luoluoluo312/STM32-ultrasonic-distance-alarm/README.md

# STM32 超声波测距报警器

基于 **STM32F103C8T6** + **标准外设库（SPL）** 的入门级小项目（Keil MDK5 工程）：
用 **HC-SR04 超声波模块**测距，把报警阈值和实时距离显示在 **0.96 寸 I2C OLED** 上，
距离小于 **10cm** 时**蜂鸣器报警**。

---

## 1. 功能

| 功能 | 说明 |
| --- | --- |
| 定时器测距 | TIM4_CH2 输入捕获测回波高电平脉宽，`距离(cm) = 脉宽(us) ÷ 58`，精度 0.1cm |
| OLED 显示 | 第 1 行固定显示报警阈值 `Threshold 10cm`，中间显示实时距离 |
| 声光报警 | 距离 < 10cm 时 PA0 输出 2.7kHz 方波驱动蜂鸣器；平时静音 |
| 超量程处理 | 没插传感器 / 超出量程时显示 `--.- cm`，**不会误报警** |
| 硬件 I2C | OLED 走 I2C1（重映射到 PB8/PB9），400kHz，从机地址 0x78 |

界面长这样（4 行，8 像素高的英文点阵字体）：

```
Threshold 10cm          <- 第 1 行：固定显示报警阈值
Distance                <- 第 2 行：标题
      12.3 cm           <- 第 3 行：实时距离（屏幕中间）
OK                      <- 第 4 行：报警状态，<10cm 时变成 ALARM  <10cm
```

---

## 2. 硬件清单

| 元器件 | 数量 | 本项目中的作用 |
| --- | --- | --- |
| STM32F103C8T6 最小系统板（蓝板） | 1 | 主控，72MHz |
| ST-Link V2 下载器 | 1 | 下载程序、调试（SWD），也可以给板子供电 |
| HC-SR04 超声波模块 | 1 | 测距 |
| 0.96 寸 I2C OLED（128×64） | 1 | 显示阈值和距离 |
| 无源蜂鸣器模块（低电平触发） | 1 | 报警 |
| 面包板 + 杜邦线 | 1 套 | 搭电路 |

---

## 3. 接线表

蓝板丝印是简写：`PB6` 印成 **B6**、`PB7` 印成 **B7**、`PA0` 印成 **A0**、`PB8/PB9` 印成 **B8/B9**。

| 模块 | 模块引脚 | 接到蓝板 | 说明 |
| --- | --- | --- | --- |
| HC-SR04 | VCC | **5V** | 建议 5V；蓝板 5V 脚只有在 USB 供电（或 ST-Link 5V 接上）时才有电 |
| HC-SR04 | Trig | **PB6** | 推挽输出 |
| HC-SR04 | Echo | **PB7** | 输入（TIM4_CH2 输入捕获）；Echo 输出 5V 电平，PB7 是 5V 容忍脚，安全 |
| HC-SR04 | GND | **GND** | |
| OLED | GND / VCC / SCL / SDA | GND / **3V3** / **PB8** / **PB9** | 从机地址 0x78，VCC 不要接 5V |
| 蜂鸣器 | VCC | **3V3** | 低电平触发的模块**必须 3.3V**，接 5V 会关不断 |
| 蜂鸣器 | I/O | **PA0** | 定时器 PWM 输出（TIM2_CH1） |
| 蜂鸣器 | GND | **GND** | |
| ST-Link | SWDIO / SWCLK / GND / 3.3V | 板子末端 4 针 SWD 排针 | |

**三条铁律**

1. 所有模块的 GND 必须和蓝板共地，否则读数乱跳。
2. 除超声波模块外，模块供电都用 3V3；接 5V 容易打坏引脚。
3. 蓝板 3V3 引脚的带载能力有限（约 100~150mA），本项目够用，但别用它驱动电机。

**两种供电方案（二选一，别混用）**

- **推荐**：蓝板插 micro-USB 供电，ST-Link 只接 SWDIO / SWCLK / GND 三根。
  这样蓝板 5V 脚有 5V，超声波可以用 5V。
- 只用 ST-Link 供电：ST-Link 的 3V3 接蓝板 3V3，超声波 VCC 也接 3V3
  （多数模块也能测，量程略短）。

**建议的接线顺序（一步一步来，别一次全插上）**

1. 先只接 **ST-Link + OLED**，上电：屏幕应显示 `Threshold 10cm` / `Distance` / `--.- cm` / `OK`。
2. 断电，接 **超声波 4 根线**，上电：`--.- cm` 变成数字，手在探头前晃动，数字跟着变。
3. 断电，接 **蜂鸣器**（VCC→3V3、I/O→PA0、GND→GND），上电。
4. 拿张纸靠近到 10cm 以内：第 4 行变成 `ALARM  <10cm`，蜂鸣器响；拿开就停。

> 每次改完接线都要**重新上电或按复位键**，因为 OLED 只在开机时初始化一次。

---

## 4. 目录结构

```
stm32模板/
├── user/                        # 用户代码（本项目主要改这里）
│   ├── main.c                   # ★ 本项目全部功能：测距 + 显示 + 报警
│   ├── stm32f10x_it.c           # 中断服务函数（SysTick 计时 + TIM4 回波捕获）
│   ├── stm32f10x_it.h
│   ├── stm32f10x_conf.h
│   └── system_stm32f10x.c/.h     # 系统时钟（72MHz）
├── my_lib/                      # 套件配套驱动库
│   ├── i2c.c/.h                 # ★ 硬件 I2C（OLED 用，带超时保护）
│   ├── oled.c/.h                # OLED 图形库：点、线、圆、矩形、位图、字符串
│   ├── oled_font.h / oled_default_font.h   # 8 像素高的英文字库
│   ├── delay.c/.h               # SysTick 毫秒 / 微秒计时
│   └── si2c.c/.h, button.c/.h, usart.c/.h, spi.c/.h   # 本项目未使用，保留
├── std_periph_driver/           # ST 官方标准外设库（SPL V3.6.0）
├── startup/                     # 启动文件（本工程用 startup_stm32f10x_md.s）
├── my_app/                      # 上一版"光照监测"项目的资料（本项目未使用，保留备查）
└── stm32模板.uvprojx             # Keil MDK5 工程文件
```

---

## 5. 编译与烧录

1. 用 **Keil µVision 5（MDK5，ARMCC V5 编译器）** 打开 `stm32模板.uvprojx`；
2. `F7` 编译（0 错误 0 警告）；
3. 接好 ST-Link，`F8` 下载；也可以直接用别的工具烧 `Objects/template.hex`。

工程已经包含全部源文件和包含路径，不需要额外配置
（芯片：STM32F103C8，ROM 64K / RAM 20K，使用 microLIB）。

> Keil 里如果看到中文注释乱码：`Edit → Configuration → Encoding` 选 **UTF-8**，
> 不影响编译结果。

---

## 6. 实现要点

### 6.1 用输入捕获测回波脉宽

TIM4 挂在 APB1 上，定时器时钟 72MHz。分频 72 之后计数频率是 **1MHz**，
也就是**一个计数正好 1 微秒**，量程 ARR = 0xFFFF（一次最多量 65.5ms；
HC-SR04 没有回波时回波高电平约 38ms，够用）。

一次测距的时序：

1. 主循环每 100ms 把 **TRIG(PB6)** 拉高约 10us 再拉低；
2. HC-SR04 发出 8 个 40kHz 脉冲，然后 **ECHO(PB7)** 变高；
3. ECHO 的**上升沿**被 TIM4_CH2 捕获，中断里记下捕获值，同时把捕获极性改成**下降沿**；
4. ECHO 的**下降沿**被捕获，中断里算
   `脉宽 = 下降沿捕获值 − 上升沿捕获值`（16 位无符号相减，自动处理计数溢出）；
5. 主循环取走脉宽算距离：`距离(0.1cm) = 脉宽(us) × 10 ÷ 58`；
6. 如果 60ms 都没等到回波，就把捕获重新武装成上升沿，距离判为无效（屏幕显示 `--.-`）。

无效范围：脉宽 < 100us（约 1.7cm）或 > 24000us（约 413cm）都当作无效，避免乱报警。

### 6.2 报警输出

PA0 复用成 **TIM2_CH1** 输出 PWM：

- 距离 < 10cm：比较值取一半，输出 **2.7kHz、50% 占空比的方波**（无源蜂鸣器这才有声）；
- 平时：比较值给 0，用 **PWM 模式2** 让引脚输出**恒高电平**，模块关断、安静。

### 6.3 OLED 用硬件 I2C1

STM32F103 的 **I2C1 默认引脚是 PB6/PB7**，而 PB6/PB7 正好被超声波占了，
所以必须打开 **I2C1 重映射**（`GPIO_PinRemapConfig(GPIO_Remap_I2C1, ENABLE)`），
把 SCL/SDA 挪到 **PB8/PB9**。这也是代码里要开 AFIO 时钟的原因。

另外 `my_lib/i2c.c` 里所有等待标志位的死循环都加了**超时**：
屏幕没接、总线没有上拉电阻时，F1 的 I2C 会把 BUSY 锁死，
原来的写法会让程序卡死在启动阶段。加了超时以后，
屏幕有问题只是不显示，测距和报警照常工作。

---

## 7. 踩过的两个坑（留着给以后的自己看）

### 7.1 冷启动黑屏，按一下复位就好了

SSD1306 上电后要等 **100ms 以上**才会应答 I2C。程序原来一上电（约 5ms）就去找它，
必然寻址失败；三次重试全失败后就再也不重试了，于是一直黑屏。

解决：初始化屏幕前先 `Delay(250)` 再重试。
后来用调试器直接驱动 I2C 总线验证过：模块确实在 0x78 地址应答，
接线和地址都没问题，纯粹是**上电时序**问题。

### 7.2 蜂鸣器不响

套件里这个模块是「**低电平触发 + 无源**」的：

- 无源蜂鸣器必须给**方波**才发声，给固定的高/低电平只会"咔"一声；
- 低电平触发意味着"给低电平才通电"，和"高电平响"正好相反。

解决：报警时输出 2.7kHz 方波，平时输出恒高电平。

---

## 8. 常见问题

| 现象 | 原因与处理 |
| --- | --- |
| 屏幕全黑 | ① 冷启动时序（已修）；② 检查 OLED 的 SCL→PB8、SDA→PB9、VCC→3V3、GND→GND；③ 改完接线要复位 |
| 一直显示 `--.- cm` | 超声波没接好：VCC/GND 是否接上、Trig 是否接 PB6、Echo 是否接 PB7 |
| 距离数值乱跳 | ① 所有模块共地了吗；② 探头表面有没有贴膜；③ 测量面太软、太斜也会跳 |
| 蜂鸣器一直响 | 蜂鸣器模块 VCC 误接 5V（低电平触发的模块必须 3.3V） |
| 蜂鸣器不响 | ① I/O 是否接到 PA0；② 模块 VCC 是否 3.3V；③ 距离要**小于** 10cm 才报警（正好 10.0cm 不报） |
| 想改引脚 | 全部集中在 `user/main.c` 顶部"一、硬件配置区" |

---

## 9. 和需求原文的一处偏差

需求原文写的是「距离 < 10cm 时 PA0 输出**高电平**驱动蜂鸣器，否则输出低电平」。
实测发现套件里这块蜂鸣器模块是**低电平触发**且**无源**的：
给它静态高电平既不响（无源需要方波），逻辑方向也是反的。所以本项目按确认后的方案改成：

- 报警时 PA0 输出 **2.7kHz 方波**；
- 平时 PA0 输出**恒高电平**（让低电平触发模块关断）。

如果以后换成「**高电平触发**」的蜂鸣器模块，想严格按需求原文做，
只需改 `Buzzer_Init()` 里两处：PWM 模式改成 `TIM_OCMode_PWM1`、
静音时的比较值改成 `ARR + 1`。代码注释里都写了。

---

## 10. 说明与致谢

- `my_lib/` 驱动库和硬件套件来自 B 站 **铁头山羊** 的
  《STM32 入门教程（第 4 版）基础套件》，本项目仅作个人学习使用。
- `std_periph_driver/` 为 ST 官方标准外设库 V3.6.0。
- `my_app/` 里的中文字库、预览脚本等是上一版"光照监测"项目留下的，本项目没用到，保留备查；
  那一版的说明文档**原样保存**在 `my_app/README-光照监测-旧项目.md`
  （它的代码在另一个仓库 [stm32project](https://github.com/luoluoluo312/stm32project) 里）。
- 为避免仓库过大，套件自带的字体文件（`my_lib/font/ttfttc/*.ttf`）和实物照片没有放进仓库。
