luoluoluo312/STM32-ultrasonic-distance-alarm/my_lib/i2c.c

/**
  ******************************************************************************
  * @file    i2c.c
  * @author  铁头山羊
  * @version V 1.0.0
  * @date    2024年9月3日
  * @brief   i2c驱动源文件
  ******************************************************************************
  */
#include "i2c.h"

//
// @简介：带超时的标志位等待
//  I2C 总线异常时（例如没接从机、总线上没有上拉电阻），BUSY/SB 等标志可能
//  一直不翻转，这里加超时，避免程序死等。
// @返回值：0 - 等到， -1 - 超时
//
#define MY_I2C_TIMEOUT   100000UL

static int My_I2C_WaitFlag(I2C_TypeDef *I2Cx, uint32_t Flag, FlagStatus Status)
{
	uint32_t Timeout = MY_I2C_TIMEOUT;
	
	while(I2C_GetFlagStatus(I2Cx, Flag) != Status)
	{
		if(--Timeout == 0)
		{
			return -1;
		}
	}
	
	return 0;
}

//
// @简介：通过I2C向从机写入多个字节
// 
// @参数 I2Cx：填写要操作的I2C的名称，可以是I2C1或I2C2
// @参数 Addr：填写从机的地址，左对齐 - A6 A5 A4 A3 A2 A1 A0 0
// @参数 pData：要发送的数据（数组）
// @参数 Size：要发送的数据的数量，以字节为单位
//
// @返回值：0 - 发送成功， -1 - 寻址失败， -2 - 数据被拒收， -3 - 超时(总线异常)
//
__weak int My_I2C_SendBytes(I2C_TypeDef *I2Cx, uint8_t Addr, const uint8_t *pData, uint16_t Size)
{
	// #1. 等待总线空闲
	if(My_I2C_WaitFlag(I2Cx, I2C_FLAG_BUSY, RESET) != 0)
	{
		return -3; // 总线一直忙（例如从机没接、总线没有上拉）
	}
	
	// #2. 发送起始位
	I2C_GenerateSTART(I2Cx, ENABLE);
	
	if(My_I2C_WaitFlag(I2Cx, I2C_FLAG_SB, SET) != 0)
	{
		I2C_GenerateSTOP(I2Cx, ENABLE);
		return -3; // 起始位没能发出去
	}
	
	// #3. 寻址阶段
	I2C_ClearFlag(I2Cx, I2C_FLAG_AF);
	
	I2C_SendData(I2Cx, Addr & 0xfe);
	
	uint32_t Timeout = MY_I2C_TIMEOUT;
	
	while(1)
	{
		if(I2C_GetFlagStatus(I2Cx, I2C_FLAG_ADDR) == SET)
		{
			break;
		}
		if(I2C_GetFlagStatus(I2Cx, I2C_FLAG_AF) == SET)
		{
			I2C_GenerateSTOP(I2Cx, ENABLE);
			return -1; // 寻址失败
		}
		if(--Timeout == 0)
		{
			I2C_GenerateSTOP(I2Cx, ENABLE);
			return -3; // 超时
		}
	}
	
	// 清除ADDR
	I2C_ReadRegister(I2Cx, I2C_Register_SR1);
	I2C_ReadRegister(I2Cx, I2C_Register_SR2);
	
	// #4. 发送数据
	for(uint16_t i=0; i<Size; i++)
	{
		Timeout = MY_I2C_TIMEOUT;
		
		while(1)
		{
			if(I2C_GetFlagStatus(I2Cx, I2C_FLAG_AF) == SET)
			{
				I2C_GenerateSTOP(I2Cx, ENABLE);
				return -2; // 数据被拒收
			}
			if(I2C_GetFlagStatus(I2Cx, I2C_FLAG_TXE) == SET)
			{
				break;
			}
			if(--Timeout == 0)
			{
				I2C_GenerateSTOP(I2Cx, ENABLE);
				return -3; // 超时
			}
		}
		
		I2C_SendData(I2Cx, pData[i]);
	}
	
	Timeout = MY_I2C_TIMEOUT;
	
	while(1)
	{
		if(I2C_GetFlagStatus(I2Cx, I2C_FLAG_AF) == SET)
		{
				I2C_GenerateSTOP(I2Cx, ENABLE);
				return -2; // 数据被拒收			
		}
		
		if(I2C_GetFlagStatus(I2Cx, I2C_FLAG_BTF) == SET)
		{
			break;
		}
		
		if(--Timeout == 0)
		{
				I2C_GenerateSTOP(I2Cx, ENABLE);
				return -3; // 超时
		}
	}
	
	// #5. 发送停止位
	I2C_GenerateSTOP(I2Cx, ENABLE);
	return 0; // 成功
}


//
// @简介：通过I2C从从机读多个字节
// 
// @参数 I2Cx：填写要操作的I2C的名称，可以是I2C1或I2C2
// @参数 Addr：填写从机的地址，左对齐 - A6 A5 A4 A3 A2 A1 A0 0
// @参数 pBuffer：接收缓冲区（数组）
// @参数 Size：要读取的数据的数量，以字节为单位
//
// @返回值：0 - 发送成功， -1 - 寻址失败
//
__weak int My_I2C_ReceiveBytes(I2C_TypeDef *I2Cx, uint8_t Addr, uint8_t *pBuffer, uint16_t Size)
{
	if(Size == 0) return 0;
	
	// #1. 等待总线空闲
	while(I2C_GetFlagStatus(I2Cx, I2C_FLAG_BUSY) == SET);
	
	// #2. 发送起始位
	I2C_GenerateSTART(I2Cx, ENABLE);
	
	while(I2C_GetFlagStatus(I2Cx, I2C_FLAG_SB) == RESET);
	
	// #3. 寻址阶段
	I2C_ClearFlag(I2Cx, I2C_FLAG_AF);
	
	I2C_SendData(I2Cx, Addr | 0x01);
	
	while(1)
	{
		if(I2C_GetFlagStatus(I2Cx, I2C_FLAG_ADDR) == SET)
		{
			break;
		}
		if(I2C_GetFlagStatus(I2Cx, I2C_FLAG_AF) == SET)
		{
			I2C_GenerateSTOP(I2Cx, ENABLE);
			return -1; // 寻址失败
		}
	}
	
	// #4. 数据读取
	if(Size == 1)
	{
		// 向ACK写0
		I2C_AcknowledgeConfig(I2Cx, DISABLE);
		
		// 清除ADDR
		__disable_irq();
		I2C_ReadRegister(I2Cx, I2C_Register_SR1);
		I2C_ReadRegister(I2Cx, I2C_Register_SR2);
		
		// 发送停止位
		I2C_GenerateSTOP(I2Cx, ENABLE);
		__enable_irq();
		// 等待RxNE置位
		while(I2C_GetFlagStatus(I2Cx, I2C_FLAG_RXNE) == RESET);
		// 读取数据
		pBuffer[0] = I2C_ReceiveData(I2Cx);
	}
	else
	{
		// 向ACK写1
		I2C_AcknowledgeConfig(I2Cx, ENABLE);
		
		// 清除ADDR
		I2C_ReadRegister(I2Cx, I2C_Register_SR1);
		I2C_ReadRegister(I2Cx, I2C_Register_SR2);
		
		for(uint16_t i=0; i<Size-1; i++)
		{
			if(i==Size-2)
			{
				__disable_irq();
			}
			// 等待RxNE置位
			while(I2C_GetFlagStatus(I2Cx, I2C_FLAG_RXNE) == RESET);
			// 读取
			pBuffer[i] = I2C_ReceiveData(I2Cx);
		}
		
		// 向ACK写0
		I2C_AcknowledgeConfig(I2Cx, DISABLE);
		// 发送停止位
		I2C_GenerateSTOP(I2Cx, ENABLE);
		
		__enable_irq();
		
		// 等待RxNE置位
		while(I2C_GetFlagStatus(I2Cx, I2C_FLAG_RXNE) == RESET);
		pBuffer[Size-1] = I2C_ReceiveData(I2Cx);
	}
	
	return 0;
}
