luoluoluo312/STM32-ultrasonic-distance-alarm/(commit log)

2026-09-26 导入完整项目：STM32 光照监测与天黑报警器 (v1.1)
    - user/main.c：ADC 双通道采集 + 中文四页 OLED 界面 + 天黑报警 + 按键 + 串口上报 + RAM 历史统计
    - my_app/：中文字库生成脚本、界面预览图、接线与调试文档、串口读取脚本
    - README.md：项目介绍、硬件清单、接线表、按键说明、编译烧录、实现要点、常见问题
    - .gitignore：排除 Keil 编译产物、个人界面设置与 43MB 字体文件
    [i2c.c]
2026-10-03 完成 HC-SR04 超声波测距报警器：TIM4 输入捕获测距 + OLED 显示阈值与距离 + 蜂鸣器方波报警
2026-10-03 README 改为超声波测距报警器的项目介绍，旧项目说明原样保留到 my_app/
